nishuidegou/motor_drive/hw/motor_driver.png

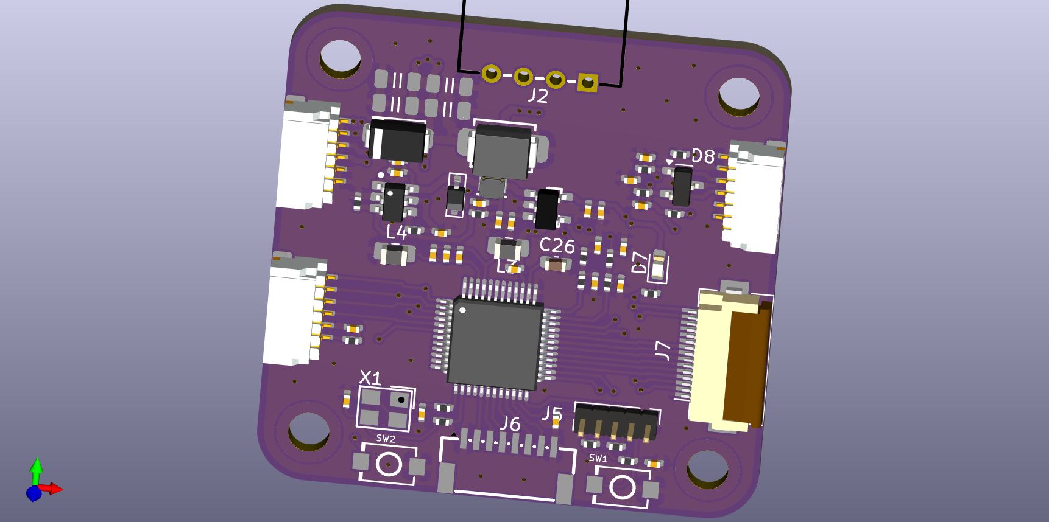
hw/motor_driver.png
