nishuidegou/motor_drive/README.md

# motor_drive

机器人机械臂电机驱动项目。

- `sw/` —— 步进电机驱动软件（Nuvoton M2L31 + 2×AS4950，Keil MDK 工程）
- `hw/` —— 硬件（KiCad 原理图 + PCB + BOM）
