nishuidegou/motor_drive/hw/motor_driver.pdf

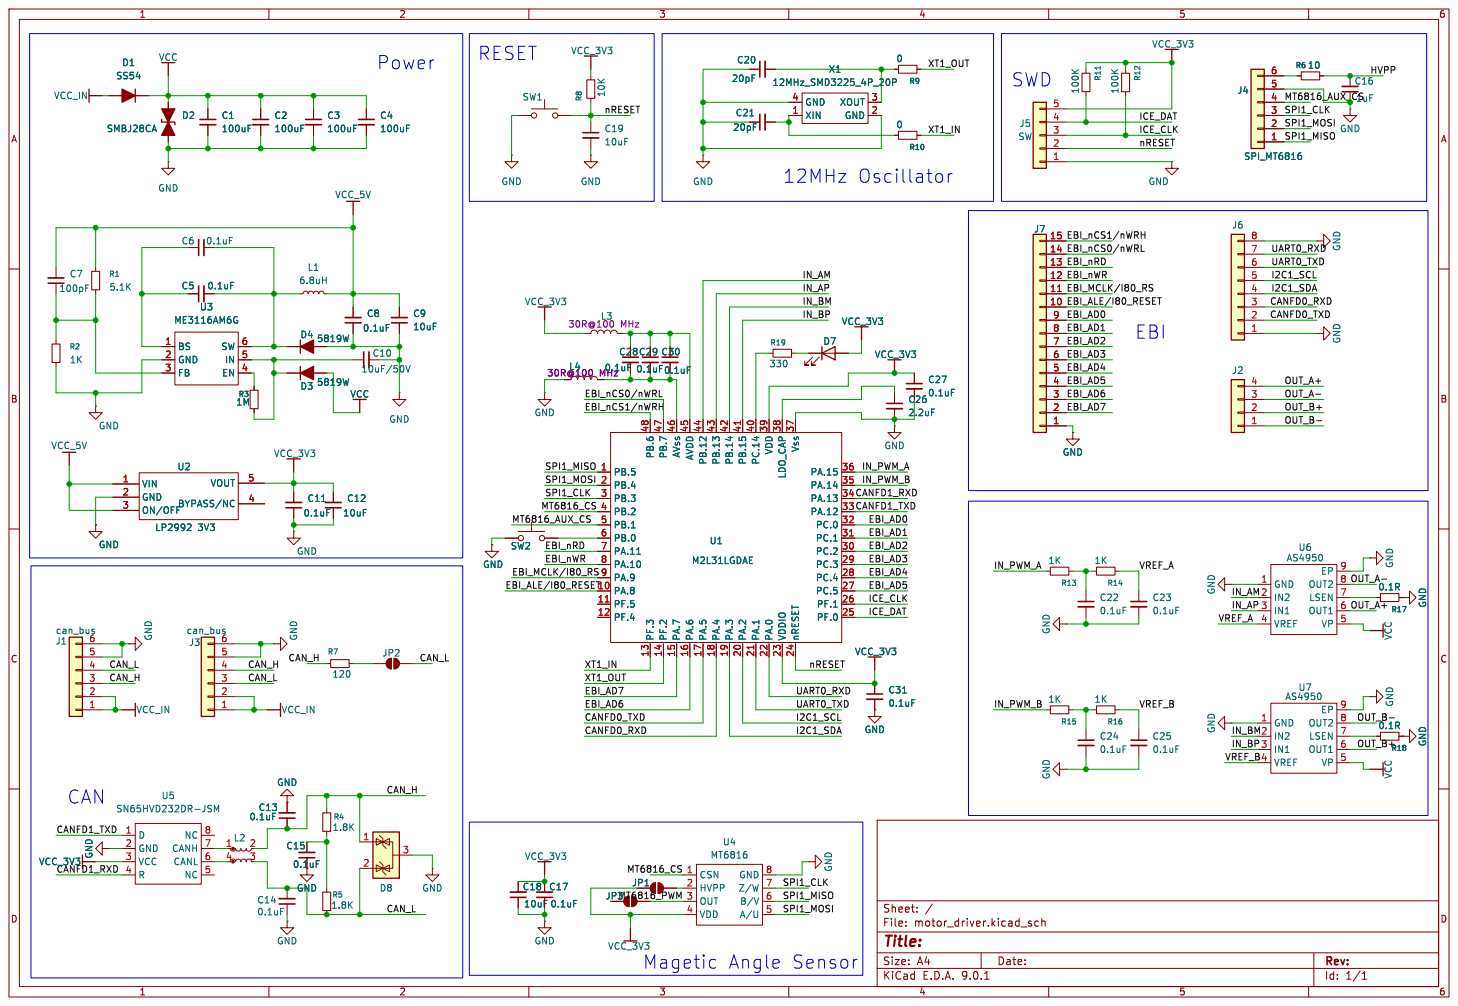
[picture p2: page 1]

Id: 1/1 Title: File: motor_driver.kicad_sch Sheet: /
