nishuidegou/motor_drive/hw/motor_driver.kicad_pcb

## KiCad design hw/motor_driver.kicad_pcb (2026-11-08)

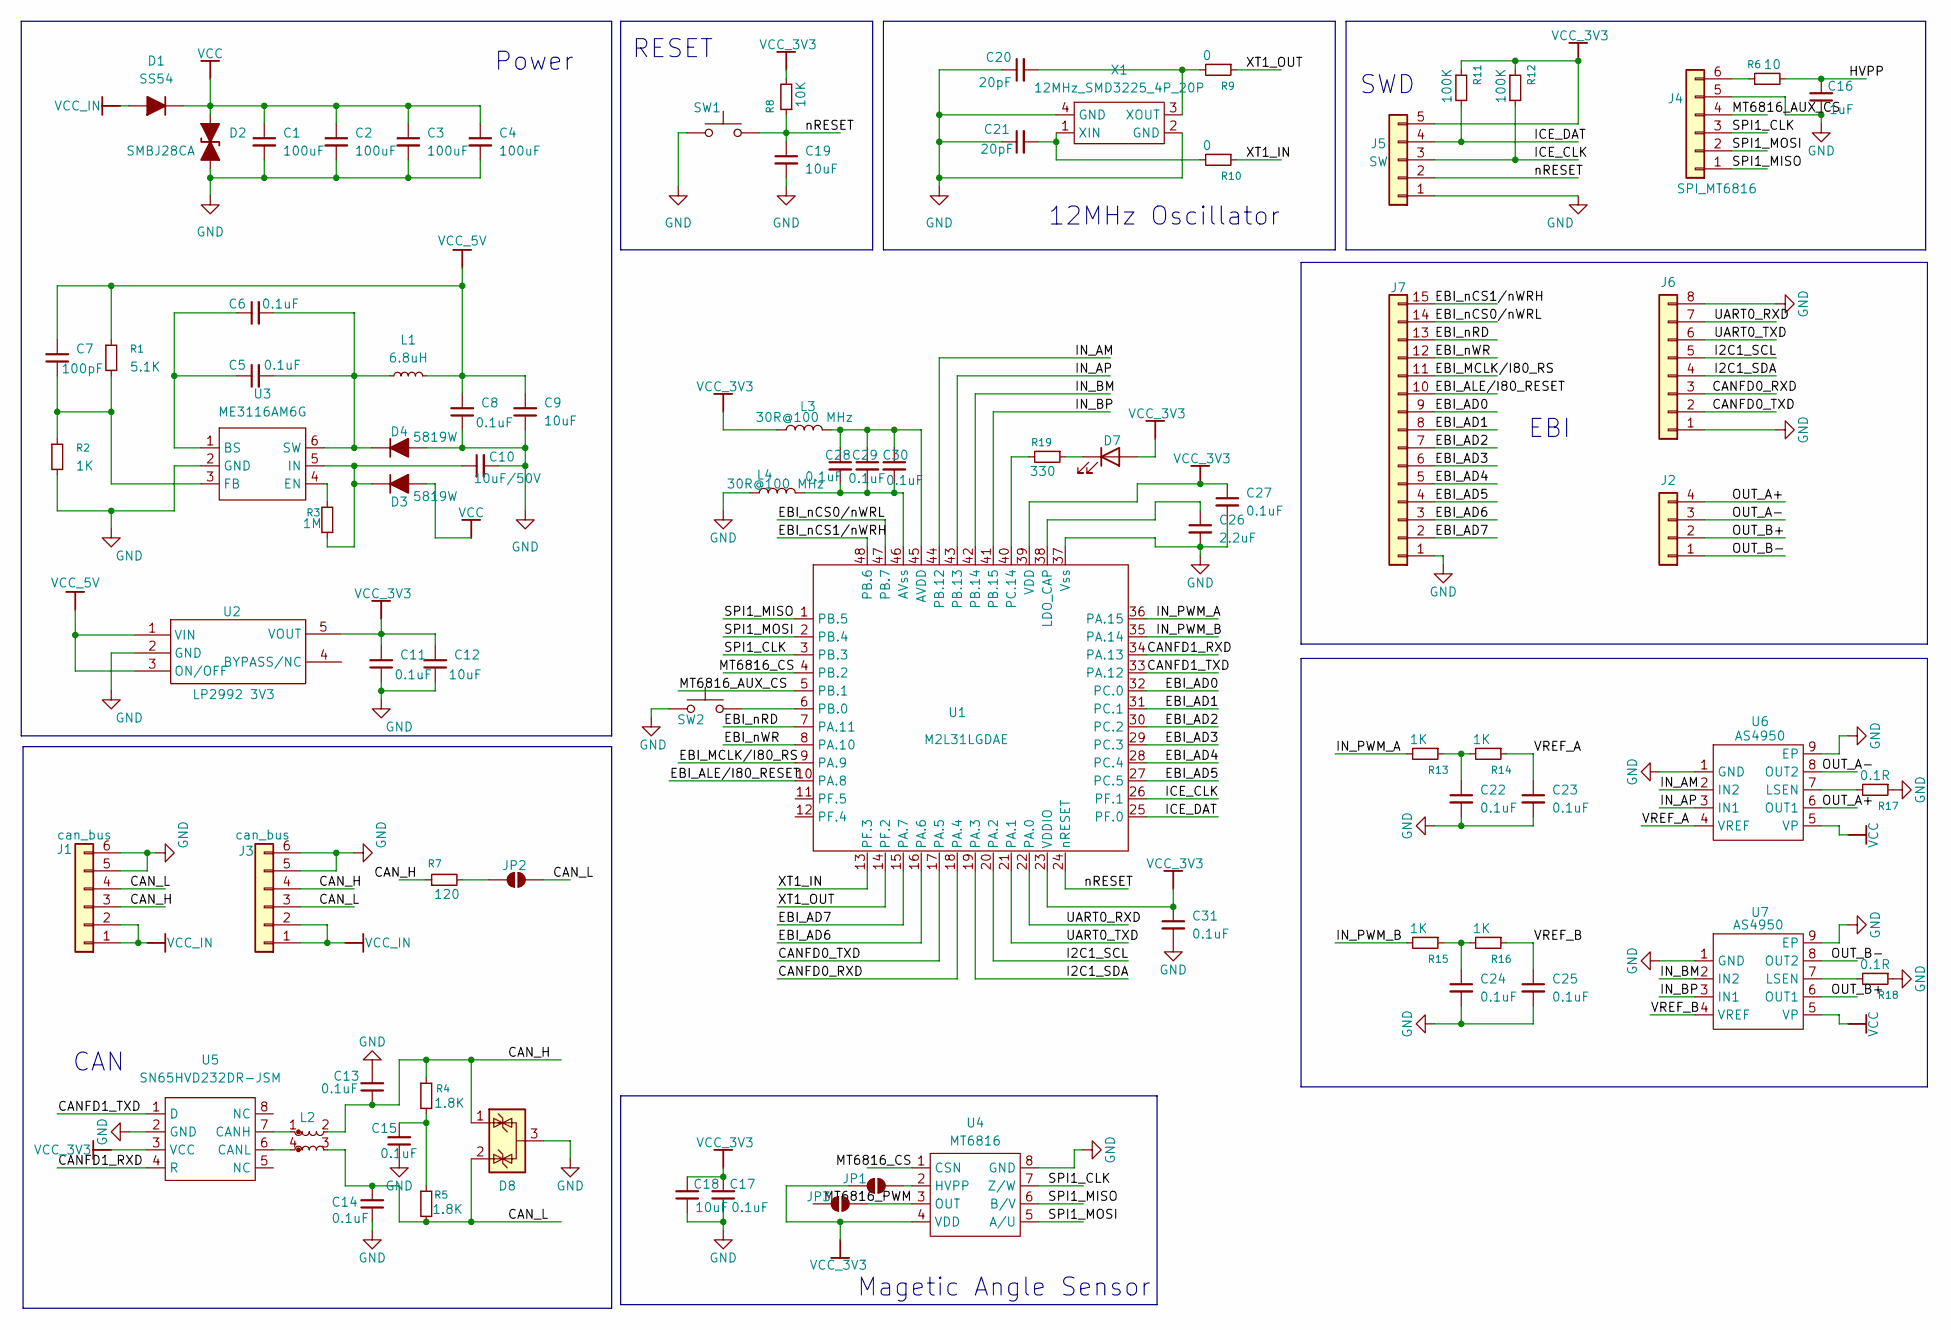
[picture p3: schematic motor_driver.kicad_sch]

Parts:
C1, C2, C3, C4: 100uF; 1206-CAP
C5, C6, C8, C11, C13, C14, C15, C17, C22, C23, C24, C25, C27, C28, C29, C30, C31: 0.1uF; CAP_0402
C7: 100pF; CAP_0402
C9, C12, C18, C19: 10uF; CAP_0402
C10: 10uF/50V; CAP_0402
C16: 1uF; CAP_0402
C20, C21: 20pF; CAP_0402
C26: 2.2uF; C_0603_1608Metric
D1: SS54; DO-214AC
D2: SMBJ28CA; SMBJ-CA_MFG
D3, D4: 5819W; SOD-323
D7: 0603_GREEN_19-217/GHC-YR1S2/3T; LED_0603_1608Metric; MPN 19-217/GHC-YR1S2/3T
D8: NUP2105L; SOT-23
J1, J3: can_bus; SH1.0-6P
J2: Conn_01x04; CONN-TH_4P-P2.50_ZX-XH2.54-4PWZ
J4: SPI_MT6816; SH1.0-6P
J5: SW; PinHeader_1x05_P1.27mm_Vertical
J6: Conn_01x08; CONN-SMD_8P-P1.00_MEGASTAR_ZX-SH1.0-8PWT
J7: Conn_01x15; Hirose_FH12-15S-0.5SH_1x15-1MP_P0.50mm_Horizontal
JP1, JP2, JP3: SolderJumper_2_Open; RES_0402
L1: 6.8uH; IND-201612
L2: L_Coupled_Small; L_CommonMode_Wurth_WE-CNSW-1206
L3, L4: FB_2A_0805_220R@100MHz_BLM21PG221SN1D; L_0805_2012Metric_Pad1.15x1.40mm_HandSolder; Rating 2A; MPN BLM21PG221SN1D
R1: 5.1K; RES_0402
R2, R13, R14, R15, R16: 1K; RES_0402
R3: 1M; RES_0402
R4, R5: 1.8K; RES_0402
R6: 10; RES_0402
R7: 120; RES_0402
R8: 10K; RES_0402
R9, R10: 0; RES_0402
R11, R12: 100K; RES_0402
R17, R18: 0.1R; 1206-RES
R19: 330; RES_0402
SW1, SW2: SW_Push; SW-SMD_L3.9-W3.0-P4.45
U1: M2L31LGDAE; LQFP-48
U2: LP2992 3V3; SOT23-5
U3: ME3116AM6G; SOT23-6
U4: MT6816; SO-8
U5: SN65HVD232DR-JSM; SO-8
U6, U7: AS4950; SO-8-PAD
X1: 12MHz_SMD3225_4P_20P; CRYSTAL-SMD_4P-L3.2-W2.5-BL

Connections:
/CANFD0_RXD: J6.3, U1.18 (PA.4)
/CANFD0_TXD: J6.2, U1.17 (PA.5)
/CANFD1_RXD: U1.34 (PA.13), U5.4 (R)
/CANFD1_TXD: U1.33 (PA.12), U5.1 (D)
/CAN_H: C13.1, D8.1 (K), J1.3, J3.4, L2.2, R4.1, R7.1
/CAN_L: C14.2, D8.2 (K), J1.4, J3.3, JP2.2 (B), L2.3, R5.2
/EBI_AD0: J7.9, U1.32 (PC.0)
/EBI_AD1: J7.8, U1.31 (PC.1)
/EBI_AD2: J7.7, U1.30 (PC.2)
/EBI_AD3: J7.6, U1.29 (PC.3)
/EBI_AD4: J7.5, U1.28 (PC.4)
/EBI_AD5: J7.4, U1.27 (PC.5)
/EBI_AD6: J7.3, U1.16 (PA.6)
/EBI_AD7: J7.2, U1.15 (PA.7)
/EBI_ALE/I80_RESET: J7.10, U1.10 (PA.8)
/EBI_MCLK/I80_RS: J7.11, U1.9 (PA.9)
/EBI_nCS0/nWRL: J7.14, U1.47 (PB.7)
/EBI_nCS1/nWRH: J7.15, U1.48 (PB.6)
/EBI_nRD: J7.13, U1.7 (PA.11)
/EBI_nWR: J7.12, U1.8 (PA.10)
/HVPP: C16.2, R6.2
/I2C1_SCL: J6.5, U1.20 (PA.2)
/I2C1_SDA: J6.4, U1.19 (PA.3)
/ICE_CLK: J5.3, R12.2, U1.26 (PF.1)
/ICE_DAT: J5.4, R11.2, U1.25 (PF.0)
/IN_AM: U1.44 (PB.12), U6.2 (IN2)
/IN_AP: U1.43 (PB.13), U6.3 (IN1)
/IN_BM: U1.42 (PB.14), U7.2 (IN2)
/IN_BP: U1.41 (PB.15), U7.3 (IN1)
/IN_PWM_A: R13.2, U1.36 (PA.15)
/IN_PWM_B: R15.2, U1.35 (PA.14)
/MT6816_AUX_CS: J4.4, U1.5 (PB.1)
/MT6816_CS: U1.4 (PB.2), U4.1 (CSN)
/MT6816_PWM: JP3.2 (B), U4.3 (OUT)
/OUT_A+: J2.4, U6.6 (OUT1)
/OUT_A-: J2.3, U6.8 (OUT2)
/OUT_B+: J2.2, U7.6 (OUT1)
/OUT_B-: J2.1, U7.8 (OUT2)
/SPI1_CLK: J4.3, U1.3 (PB.3), U4.7 (Z/W)
/SPI1_MISO: J4.1, U1.1 (PB.5), U4.6 (B/V)
/SPI1_MOSI: J4.2, U1.2 (PB.4), U4.5 (A/U)
/UART0_RXD: J6.7, U1.22 (PA.0)
/UART0_TXD: J6.6, U1.21 (PA.1)
/VREF_A: C23.1, R14.1, U6.4 (VREF)
/VREF_B: C25.1, R16.1, U7.4 (VREF)
/XT1_IN: R10.1, U1.13 (PF.3)
/XT1_OUT: R9.1, U1.14 (PF.2)
/nRESET: C19.1, J5.2, R8.1, SW1.2, U1.24 (nRESET)
GND: C1.2, C2.2, C3.2, C4.2, C8.1, C9.1, C10.2, C11.1, C12.1, C13.2, C14.1, C15.1, C16.1, C17.1, C18.1, C19.2, C20.1, C21.1, C22.2, C23.2, C24.2, C25.2, C26.2, C27.2, C31.2, D2.1 (A1), D4.2 (A), D8.3 (A), J1.5, J1.6, J3.5, J3.6, J4.5, J5.1, J6.1, J6.8, J7.1, L4.1, R2.2, R17.1, R18.1, SW1.1, SW2.1, U1.37 (Vss), U2.2 (GND), U3.2 (GND), U4.8 (GND), U5.2 (GND), U6.1 (GND), U6.9 (EP), U7.1 (GND), U7.9 (EP), X1.2 (GND), X1.4 (GND)
unnamed: C15.2, R4.2, R5.1
unnamed: C22.1, R13.1, R14.2
unnamed: C24.1, R15.1, R16.2
unnamed: C10.1, D3.1 (K), R3.1, U3.5 (IN)
unnamed: C5.2, C6.2, D4.1 (K), L1.1, U3.6 (SW)
unnamed: D7.1 (K), R19.1
unnamed: J4.6, R6.1
unnamed: JP1.2 (B), U4.2 (HVPP)
unnamed: JP2.1 (A), R7.2
unnamed: C28.1, C29.1, C30.1, L3.2, U1.45 (AVDD)
unnamed: C28.2, C29.2, C30.2, L4.2, U1.46 (AVss)
unnamed: C26.1, U1.38 (LDO_CAP)
unnamed: SW2.2, U1.6 (PB.0)
unnamed: R19.2, U1.40 (PC.14)
unnamed: C5.1, C6.1, U3.1 (BS)
unnamed: R3.2, U3.4 (EN)
unnamed: C7.1, R1.2, R2.1, U3.3 (FB)
unnamed: L2.1, U5.7 (CANH)
unnamed: L2.4, U5.6 (CANL)
unnamed: R17.2, U6.7 (LSEN)
unnamed: R18.2, U7.7 (LSEN)
unnamed: C21.2, R10.2, X1.1 (XIN)
unnamed: C20.2, R9.2, X1.3 (XOUT)
VCC: C1.1, C2.1, C3.1, C4.1, D1.1 (K), D2.2 (A2), D3.2 (A), U6.5 (VP), U7.5 (VP)
VCC_3V3: C11.2, C12.2, C17.2, C18.2, C27.1, C31.1, D7.2 (A), J5.5, JP1.1 (A), L3.1, R8.2, R11.1, R12.1, U1.23 (VDDIO), U1.39 (VDD), U2.5 (VOUT), U4.4 (VDD), U5.3 (VCC)
VCC_5V: C7.2, C8.2, C9.2, L1.2, R1.1, U2.1 (VIN), U2.3 (ON/OFF)
VCC_IN: D1.2 (A), J1.1, J1.2, J3.1, J3.2

Notes on the sheet:
Magetic Angle Sensor
SWD
EBI
CAN
Power
12MHz Oscillator
RESET

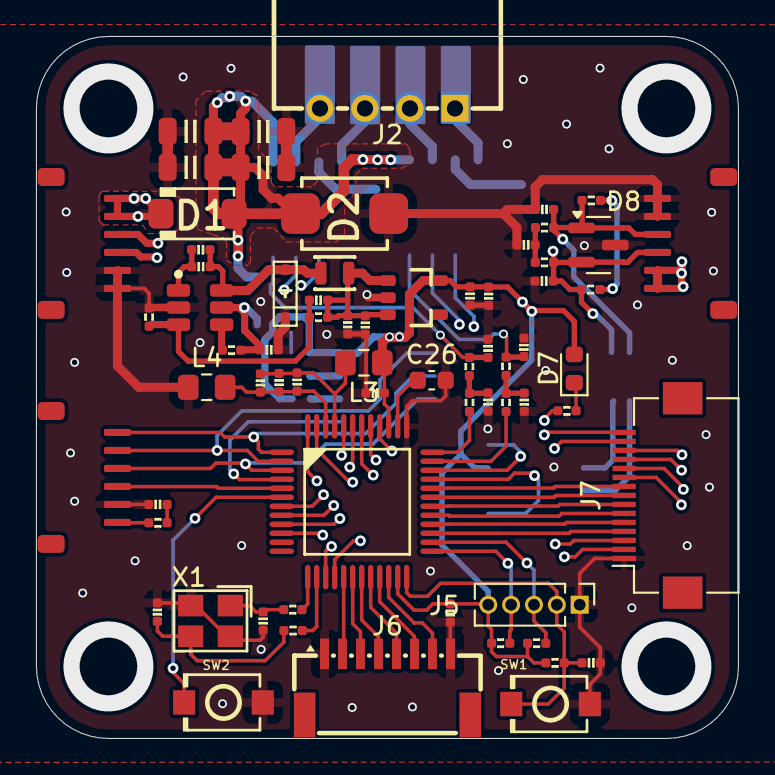
[picture p4: board motor_driver.kicad_pcb from above]

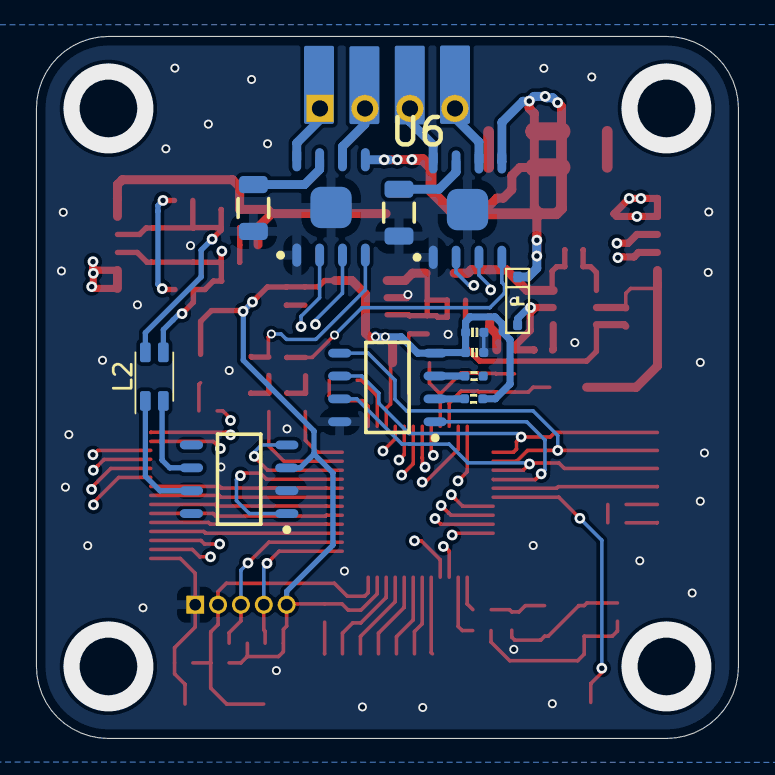
[picture p5: board motor_driver.kicad_pcb from below]

Board: 4 copper layers, 39.0 x 39.0 mm, 80 parts (12 on the bottom side), 76 nets.
