nishuidegou/motor_drive/(commit log)

2026-11-08 Add stepper motor driver software (M2L31 + 2x AS4950)
2026-11-08 Add motor driver hardware (KiCad PCB + schematic + BOM)
    [motor_driver.kicad_pcb, motor_driver.kicad_sch]
